adr1el-m/dead-channel/documentation/PUBLISHING-CHECKLIST.md

# Finish and publish

The element14 article remains a draft. Source: https://github.com/adr1el-m/channel. Browser demo: https://adr1el-m.github.io/channel/. Nothing has been posted to element14.

1. Review the first-person article for your voice and factual ownership. Keep the artwork/coding assistance credit accurate.
2. Add the gameplay video link to the marked block near the top of FORUM-POST.md. Review the actual recording before adding any claim about a complete six-call physical win.
3. Prefer a continuous shot showing the screen and hands: tune, LCD extension, keypad submission, route, safe hold, yellow/red release, one decrement, and hang-up consequences. Show the ending only if captured. Do not invent timestamps.
4. Upload the five build photos and the six diagram PNGs to the element14 editor; replace local image references with those uploaded media URLs. SVGs are editable source, not guaranteed supported inline by the forum.
5. Paste the article using the rich-text editor, retaining headings, captions and code formatting. Upload the build dossier and the source ZIP as attachments. Replace prose references to attachments with the forum's actual attachment links.
6. Test the posted draft's media, attachments and mobile readability. Remove the editorial video note only after a working embed/link exists.
7. Check the live competition brief, terms, eligibility and deadline. Choose the Halloween project area and current required tags from the platform; suggested descriptive tags: Halloween, Raspberry Pi, ESP32, Arduino, interactive game, physical computing.
8. Publish only after the above review. No external publication was performed by this documentation task.

## Asset order

Cover/build overview: IMG_3265. Close-up display: IMG_3266. ESP32 controls: IMG_3267. Nano/keypad/digit: IMG_3268 and IMG_3269. Caption the Ghost Flight menu honestly; it is shared hardware, not a photograph of Please Hold's live LCD state.

Architecture → assembly map → game flow → station diagrams. The diagrams are normalized illustrations generated from photos and current firmware, not Tinkercad exports or validated electrical simulations. Hidden breadboard row assignments are intentionally not invented.

## Attachments

- output/pdf/Dead-Channel-Build-Dossier.pdf — illustrated technical guide.
- output/Dead-Channel-Source.zip — curated runtime, sketches, tests and portable build notes; excludes caches, generated firmware binaries and machine-specific deployment configuration.
- output/Dead-Channel-Documentation.zip — complete local documentation bundle with forum draft, photographs, diagrams, netlists and PDF. This is a working package; the private editorial checklist/research do not need to be forum attachments.
