adr1el-m/dead-channel/web/art/PROMPT.md

# The Listener

Generated with the built-in image_gen tool.

Use case: stylized-concept. Create an original premium horror game key art image, portrait 5:6 composition. An enormous spectral face assembled from weathered cathedral architecture and tangled radio wires emerges above an abandoned cemetery, a tiny ivory ghost with a lantern walks a narrow path below, distant crooked towers and a black eclipsed moon. Haunting surreal woodcut meets detailed charcoal and distressed oil painting, sophisticated antique bone ivory, near-black charcoal, muted oxidized teal, very restrained vermilion glow. Intricate etched textures and dramatic atmospheric depth, genuinely unsettling and beautiful, no gore, no cartoon, no text, no typography, no interface. Face in upper half, lower third dark quiet negative space for game title overlays. Asset for Dead Channel arcade. Save generated output as a local image.
