adr1el-m/dead-channel/documentation/diagrams/console-connections.drawio.png

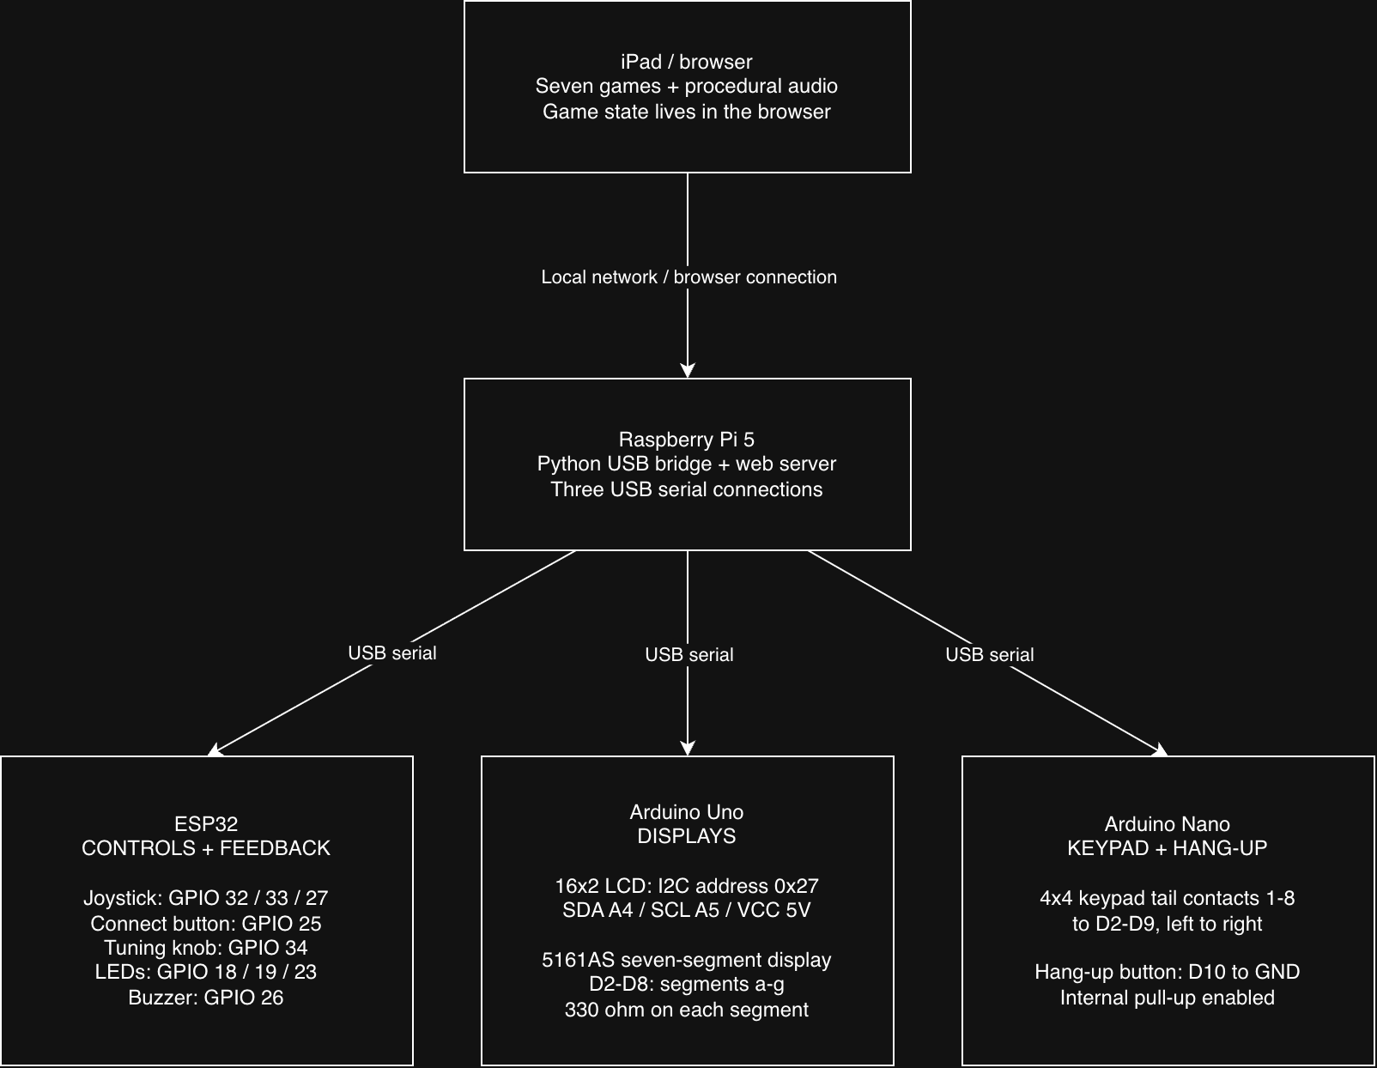
documentation/diagrams/console-connections.drawio.png
