adr1el-m/dead-channel/documentation/photos/IMG_3265-landscape.jpg

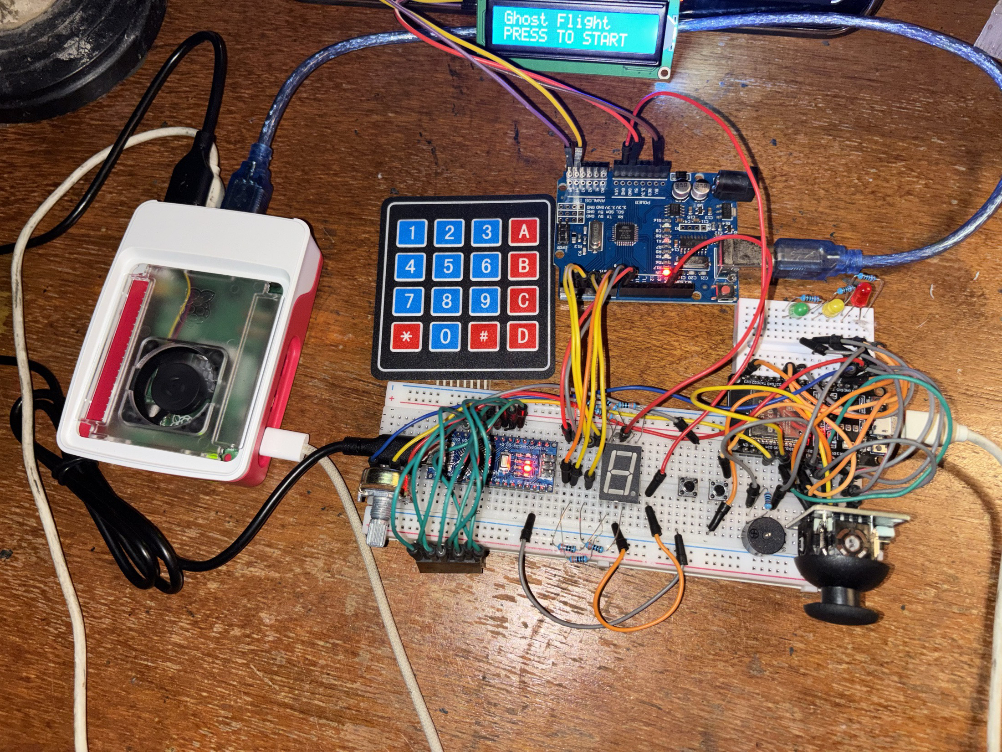
documentation/photos/IMG_3265-landscape.jpg
