adr1el-m/dead-channel/documentation/photos/IMG_3266-landscape.jpg

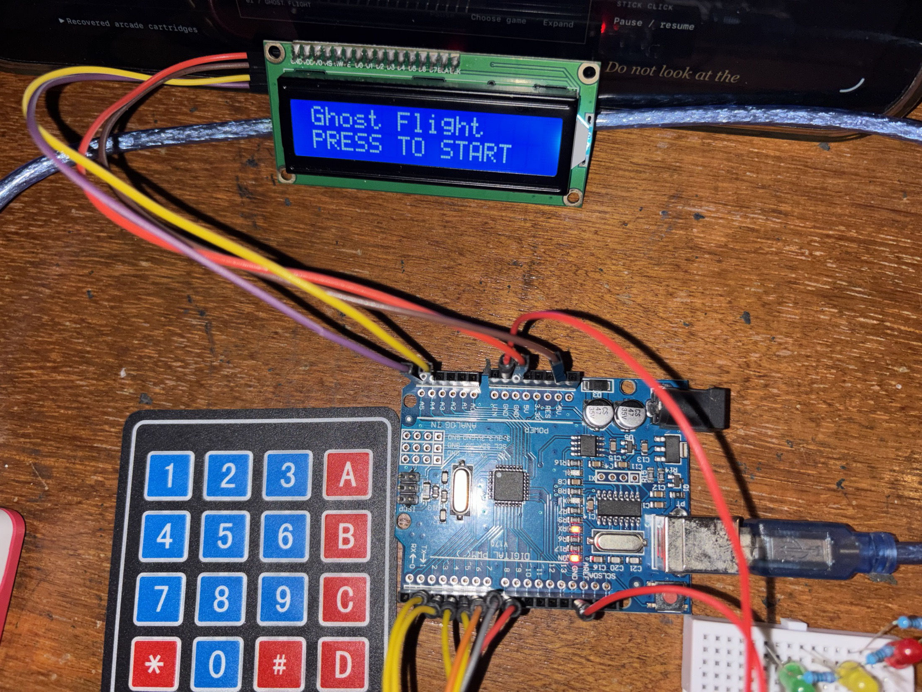
documentation/photos/IMG_3266-landscape.jpg
