adr1el-m/dead-channel/documentation/photos/IMG_3266.jpg

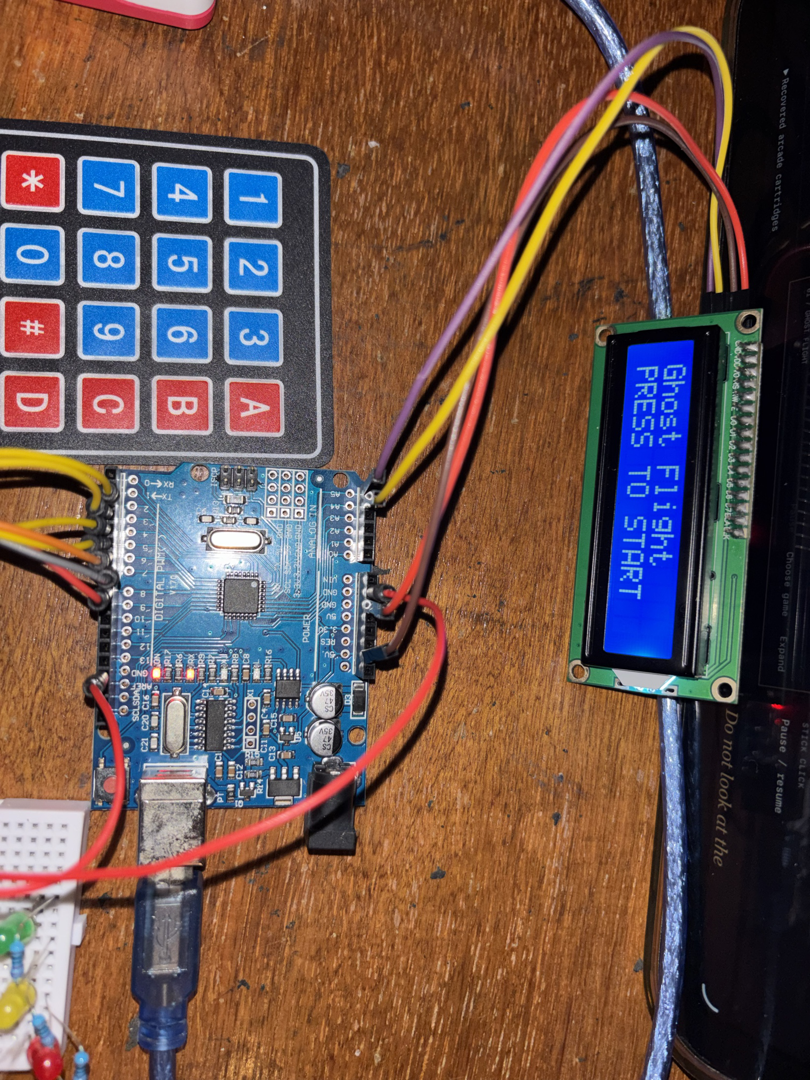
documentation/photos/IMG_3266.jpg
