adr1el-m/dead-channel/documentation/photos/IMG_3267.jpg

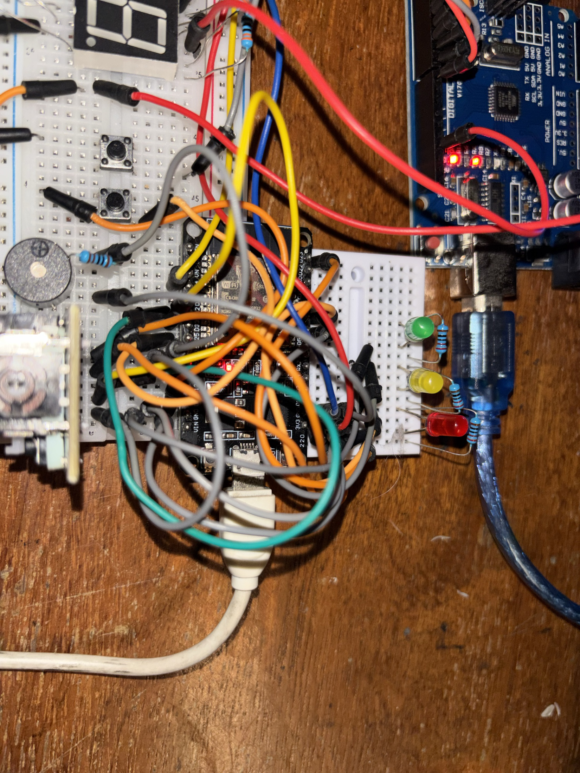
documentation/photos/IMG_3267.jpg
