adr1el-m/dead-channel/documentation/photos/IMG_3268.jpg

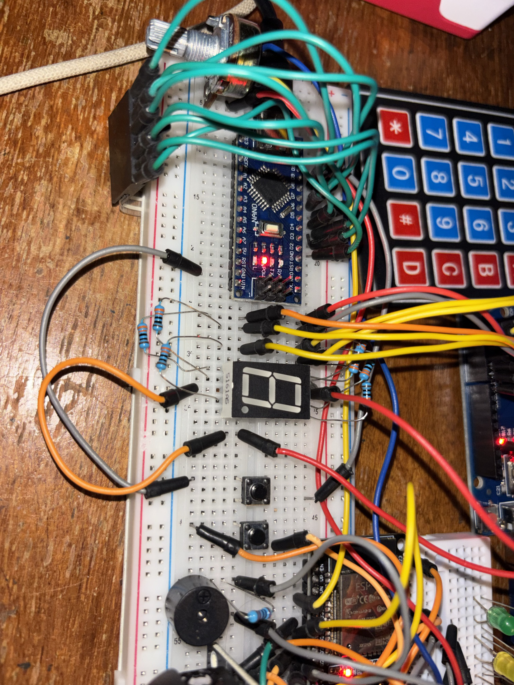
documentation/photos/IMG_3268.jpg
