adr1el-m/dead-channel/documentation/photos/IMG_3269.jpg

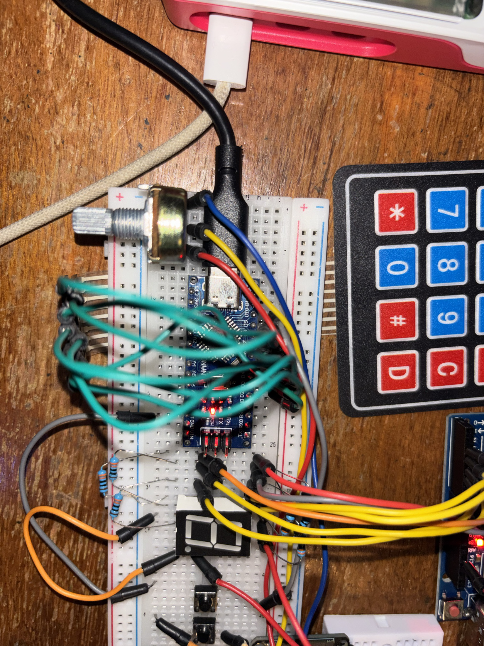
documentation/photos/IMG_3269.jpg
