adr1el-m/dead-channel/documentation/submission-images/gameplay-collage.png

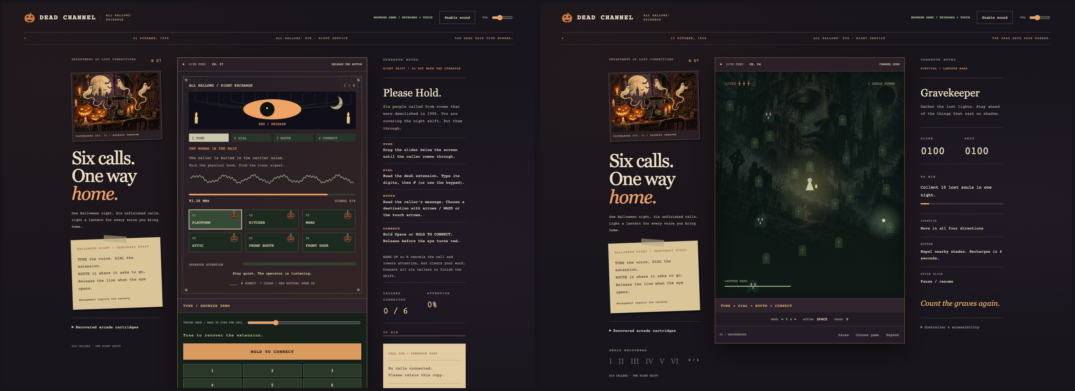
documentation/submission-images/gameplay-collage.png
