adr1el-m/dead-channel/web/art/the-listener.jpg

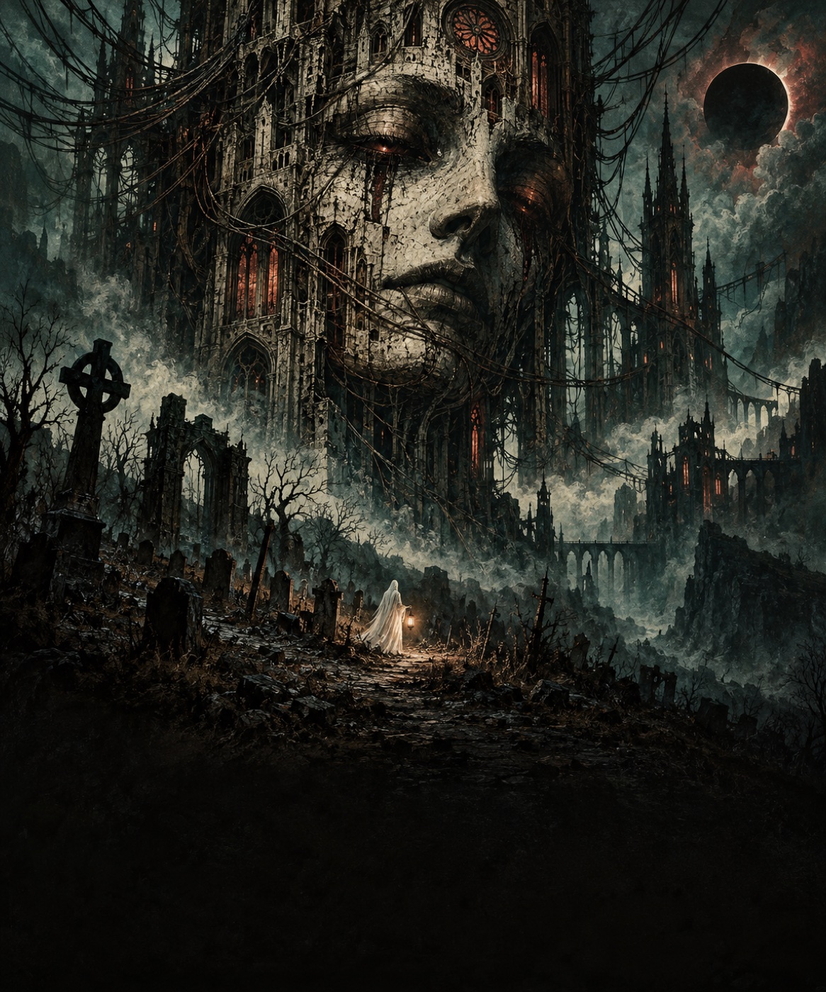
web/art/the-listener.jpg
