adr1el-m/dead-channel/documentation/research/2025-BENCHMARK.md

# Editorial benchmark — element14 Halloween

Reviewed 30 October 2026. This is an editorial comparison, not a prediction of judging or a claim that documentation alone decides a prize.

The [official 2025 results](https://community.element14.com/challenges-projects/halloween/b/news/posts/winners-announcement-element14-community-2025-halloween-competition) identify foxbat as first place, with rsc, robogary and Hacktech sharing second-place awards.

| Reviewed entry | Useful documentation practice | Application to Dead Channel |
|---|---|---|
| [foxbat — automated trick-or-treating](https://community.element14.com/challenges-projects/halloween/a/projects/PR112/automated-trick-or-treating-one-man-many-dogs-and-a-delightfully-overengineered-hallow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) | Requirements, alternate mechanisms, failures and subsystem photographs make the engineering narrative credible. | Explain the game's physical dependency chain, show the failures and include complete connection references. |
| [rsc — screaming mask](https://community.element14.com/challenges-projects/halloween/a/projects/PR105/screaming-halloween-scary-mask-with-tft-eyes-and-image-capture) | Code and display preparation details give readers concrete implementation material. | Bundle the runnable source and pin-level netlist instead of only describing the concept. |
| [robogary — animated tree](https://community.element14.com/challenges-projects/halloween/a/projects/PR107/halloween-crabby-crabapple-tree-animatronics) | Video makes the intended physical effect immediately understandable. | Lead the final post with simultaneous screen-and-hardware gameplay footage. |
| [Hacktech — The Vessel](https://community.element14.com/challenges-projects/halloween/a/projects/PR122/the-vessel-an-interactive-haunted-box-of-fog-fear-light) | Subsystems, power, sequence and fabrication files help readers follow an interactive prop. | Include signal architecture, power boundaries, game timing and editable diagrams. |

The [official roundup](https://community.element14.com/challenges-projects/halloween/f/forum/56400/a-round-up-of-every-project-halloween-hackathon-2025) highlights the first-place project's photos, videos, diagrams and an 18-page attachment. Page count is not the target: a reader should understand the effect quickly and reproduce the connections without guessing.

The [2026 brief](https://community.element14.com/challenges-projects/halloween/b/news/posts/join-the-element14-community-2026-halloween-hackathon-create-compete-for-prizes) requests a single write-up explaining the build and Halloween connection, with image/video demonstrations; it names originality, innovation and technical merit. The page lists a closing time of 23:59 UK on 15 November 2026. Check the current page and complete terms before submitting; this package does not establish eligibility.

## Our quality bar

A concise narrative, actual photographs, one coherent physical game, six readable diagrams, a machine-readable netlist, source attachments, and an honest fault/validation record. Avoid fabricated measurements, simulated images presented as photographs, unsupported complete-win claims and missing media presented as a working link. The unreviewed gameplay recording is the remaining publication dependency.
